abmj01/Project_integration/(commit log)

2024-05-27 directory changed based on Arduino project skeleton
2024-06-10 Integrated Battery_monitoring and displaying battery life
2024-06-12 Functionality test passed before rearranging the breadboard connetion to match the PCB connections
2024-06-17 Modified student mistake push
    [Notification_sender.h, Notification_sender.ino, Oled_display.ino, SmartWatch.ino]
